LArielOzjH/TernaryCIM/algorithm/bar.png

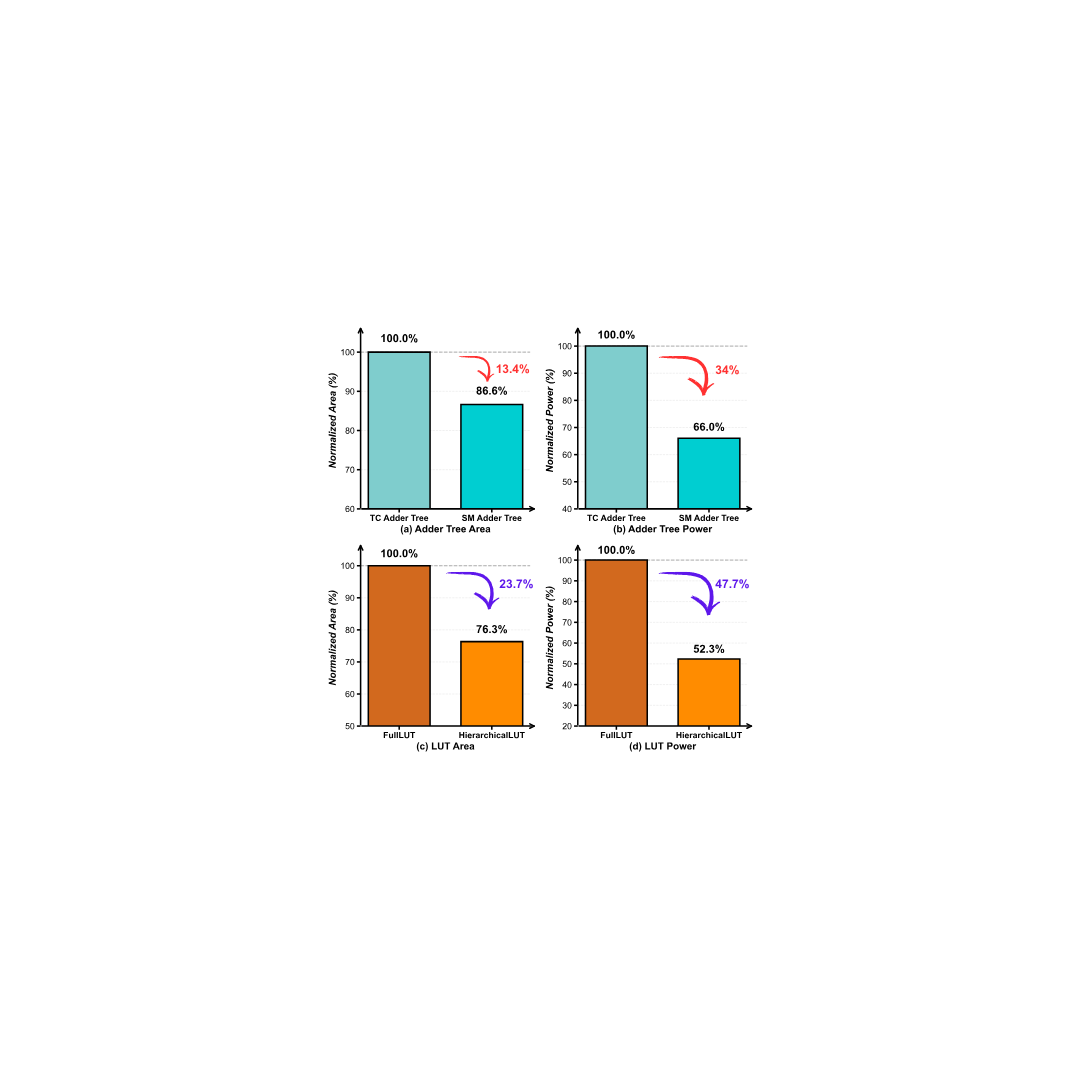
algorithm/bar.png
