LArielOzjH/TernaryCIM/algorithm/ablation_bar.pdf

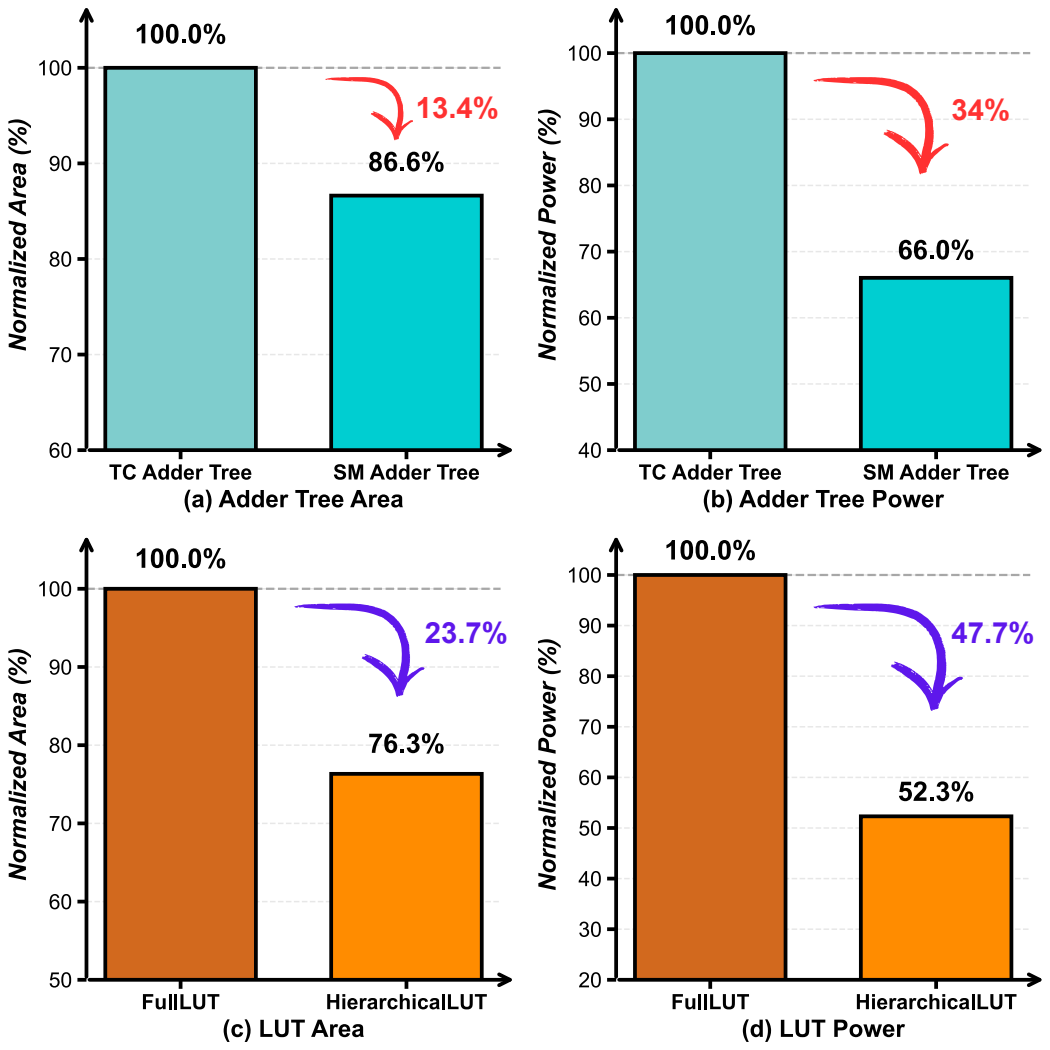
[picture p4: page 1]
