LArielOzjH/TernaryCIM/hw/CimDecoder.syn.v

/////////////////////////////////////////////////////////////
// Created by: Synopsys DC Ultra(TM) in wire load mode
// Version   : P-2019.03-SP5
// Date      : Tue Mar 24 18:19:15 2026
/////////////////////////////////////////////////////////////


module CimDecoder ( CK, ADDR, WRWL );
  input [6:0] ADDR;
  output [127:0] WRWL;
  input CK;
  wire   n40, n41, n42, n43, n44, n45, n46, n47, n48, n49, n50, n51, n52, n53,
         n54, n55, n56, n57, n58, n59, n60, n61, n62, n63, n64, n65, n66, n67,
         n68, n69, n70, n71, n72, n73, n74, n75, n76, n77, n78, n79, n80, n81,
         n82, n83, n84, n85, n86, n87, n88, n89, n90, n91, n92, n93, n94, n95,
         n96, n97, n98, n99, n100, n101, n102, n103, n104, n105, n106, n107,
         n108, n109, n110, n111, n112, n113, n114, n115, n116, n117, n118,
         n119, n120, n121, n122, n123, n124, n125, n126, n127, n128, n129,
         n130, n131, n132, n133, n134, n135, n136, eco_net;

  AN3D1BWP6T20P96CPD U169 ( .A1(n120), .A2(ADDR[2]), .A3(ADDR[1]), .Z(n40) );
  AN3D1BWP6T20P96CPD U170 ( .A1(ADDR[1]), .A2(n122), .A3(n119), .Z(n41) );
  AN2D1BWP6T20P96CPD U171 ( .A1(n120), .A2(n121), .Z(n42) );
  AN2D1BWP6T20P96CPD U172 ( .A1(n120), .A2(n118), .Z(n43) );
  AN2D1BWP6T20P96CPD U173 ( .A1(n121), .A2(n122), .Z(n44) );
  AN2D1BWP6T20P96CPD U174 ( .A1(n122), .A2(n118), .Z(n45) );
  AN2D1BWP6T20P96CPD U175 ( .A1(n132), .A2(n125), .Z(n46) );
  AN2D1BWP6T20P96CPD U176 ( .A1(n132), .A2(n127), .Z(n47) );
  AN2D1BWP6T20P96CPD U177 ( .A1(n132), .A2(n129), .Z(n48) );
  AN2D1BWP6T20P96CPD U178 ( .A1(n133), .A2(n125), .Z(n49) );
  AN2D1BWP6T20P96CPD U179 ( .A1(n133), .A2(n127), .Z(n50) );
  AN2D1BWP6T20P96CPD U180 ( .A1(n133), .A2(n129), .Z(n51) );
  AN2D1BWP6T20P96CPD U181 ( .A1(n130), .A2(n125), .Z(n52) );
  AN2D1BWP6T20P96CPD U182 ( .A1(n130), .A2(n127), .Z(n53) );
  AN2D1BWP6T20P96CPD U183 ( .A1(n130), .A2(n129), .Z(n54) );
  AN2D1BWP6T20P96CPD U184 ( .A1(n130), .A2(n134), .Z(n55) );
  AN2D1BWP6T20P96CPD U185 ( .A1(n131), .A2(n127), .Z(n56) );
  AN2D1BWP6T20P96CPD U186 ( .A1(n131), .A2(n125), .Z(n57) );
  AN2D1BWP6T20P96CPD U187 ( .A1(n131), .A2(n129), .Z(n58) );
  AN2D1BWP6T20P96CPD U188 ( .A1(n134), .A2(n131), .Z(n59) );
  AN2D1BWP6T20P96CPD U189 ( .A1(n134), .A2(n132), .Z(n60) );
  AN2D1BWP6T20P96CPD U190 ( .A1(n134), .A2(n133), .Z(n61) );
  INVD1BWP6T20P96CPD U191 ( .I(n55), .ZN(n62) );
  INVD1BWP6T20P96CPD U192 ( .I(n55), .ZN(n63) );
  INVD1BWP6T20P96CPD U193 ( .I(n57), .ZN(n64) );
  INVD1BWP6T20P96CPD U194 ( .I(n57), .ZN(n65) );
  INVD1BWP6T20P96CPD U195 ( .I(n46), .ZN(n66) );
  INVD1BWP6T20P96CPD U196 ( .I(n46), .ZN(n67) );
  INVD1BWP6T20P96CPD U197 ( .I(n49), .ZN(n68) );
  INVD1BWP6T20P96CPD U198 ( .I(n49), .ZN(n69) );
  INVD1BWP6T20P96CPD U199 ( .I(n52), .ZN(n70) );
  INVD1BWP6T20P96CPD U200 ( .I(n52), .ZN(n71) );
  INVD1BWP6T20P96CPD U201 ( .I(n56), .ZN(n72) );
  INVD1BWP6T20P96CPD U202 ( .I(n56), .ZN(n73) );
  INVD1BWP6T20P96CPD U203 ( .I(n47), .ZN(n74) );
  INVD1BWP6T20P96CPD U204 ( .I(n47), .ZN(n75) );
  INVD1BWP6T20P96CPD U205 ( .I(n50), .ZN(n76) );
  INVD1BWP6T20P96CPD U206 ( .I(n50), .ZN(n77) );
  INVD1BWP6T20P96CPD U207 ( .I(n53), .ZN(n78) );
  INVD1BWP6T20P96CPD U208 ( .I(n53), .ZN(n79) );
  INVD1BWP6T20P96CPD U209 ( .I(n58), .ZN(n80) );
  INVD1BWP6T20P96CPD U210 ( .I(n58), .ZN(n81) );
  INVD1BWP6T20P96CPD U211 ( .I(n48), .ZN(n82) );
  INVD1BWP6T20P96CPD U212 ( .I(n48), .ZN(n83) );
  INVD1BWP6T20P96CPD U213 ( .I(n51), .ZN(n84) );
  INVD1BWP6T20P96CPD U214 ( .I(n51), .ZN(n85) );
  INVD1BWP6T20P96CPD U215 ( .I(n54), .ZN(n86) );
  INVD1BWP6T20P96CPD U216 ( .I(n54), .ZN(n87) );
  INVD1BWP6T20P96CPD U217 ( .I(n59), .ZN(n88) );
  INVD1BWP6T20P96CPD U218 ( .I(n59), .ZN(n89) );
  INVD1BWP6T20P96CPD U219 ( .I(n60), .ZN(n90) );
  INVD1BWP6T20P96CPD U220 ( .I(n60), .ZN(n91) );
  INVD1BWP6T20P96CPD U221 ( .I(n61), .ZN(n92) );
  INVD1BWP6T20P96CPD U222 ( .I(n61), .ZN(n93) );
  INVD1BWP6T20P96CPD U223 ( .I(n42), .ZN(n94) );
  INVD1BWP6T20P96CPD U224 ( .I(n42), .ZN(n95) );
  INVD1BWP6T20P96CPD U225 ( .I(n42), .ZN(n96) );
  INVD1BWP6T20P96CPD U226 ( .I(n45), .ZN(n97) );
  INVD1BWP6T20P96CPD U227 ( .I(n45), .ZN(n98) );
  INVD1BWP6T20P96CPD U228 ( .I(n45), .ZN(n99) );
  INVD1BWP6T20P96CPD U229 ( .I(n43), .ZN(n100) );
  INVD1BWP6T20P96CPD U230 ( .I(n43), .ZN(n101) );
  INVD1BWP6T20P96CPD U231 ( .I(n43), .ZN(n102) );
  INVD1BWP6T20P96CPD U232 ( .I(n44), .ZN(n103) );
  INVD1BWP6T20P96CPD U233 ( .I(n44), .ZN(n104) );
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
  NR2D1BWP6T20P96CPD U391 ( .A1(n63), .A2(n106), .ZN(WRWL[3]) );
  NR2D1BWP6T20P96CPD U392 ( .A1(n62), .A2(n115), .ZN(WRWL[2]) );
  NR2D1BWP6T20P96CPD U393 ( .A1(n63), .A2(n103), .ZN(WRWL[1]) );
  DELCD1BWP6T20P96CPD eco_cell ( .I(CK), .Z(eco_net) );
endmodule
